ionos-sdr/ionos-maximus-rpi-sdr/docs/img/rev-a_on_rpi3b_iso.png

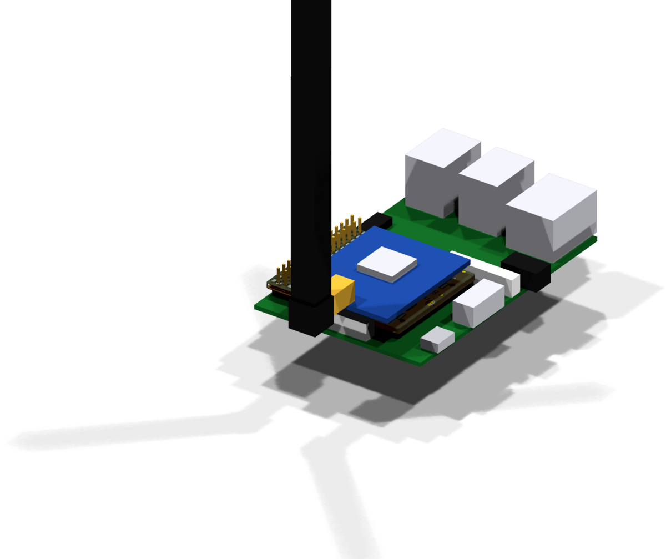
docs/img/rev-a_on_rpi3b_iso.png
