ionos-sdr/ionos-maximus-rpi-sdr/docs/img/rev-a_on_rpi3b_top.png

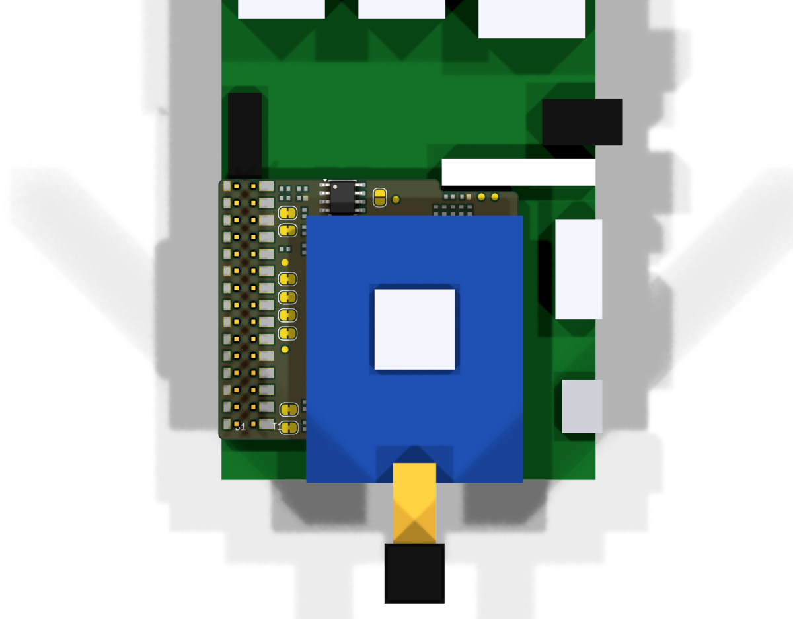
docs/img/rev-a_on_rpi3b_top.png
