ionos-sdr/ionos-maximus-rpi-sdr/docs/img/social_card.png

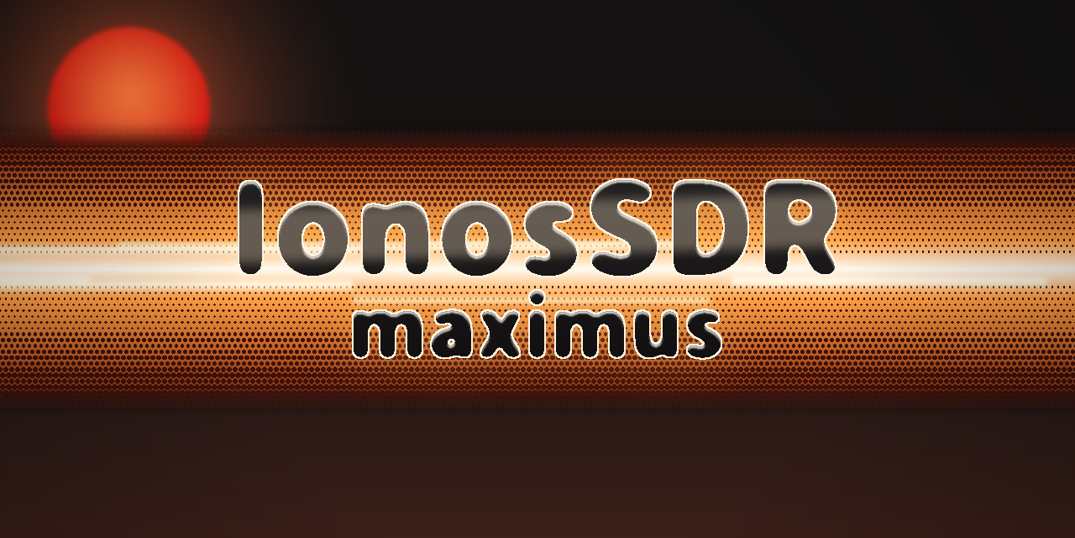
docs/img/social_card.png
