ionos-sdr/ionos-maximus-rpi-sdr/hardware/kicad/3dmodels/L5_0603.step

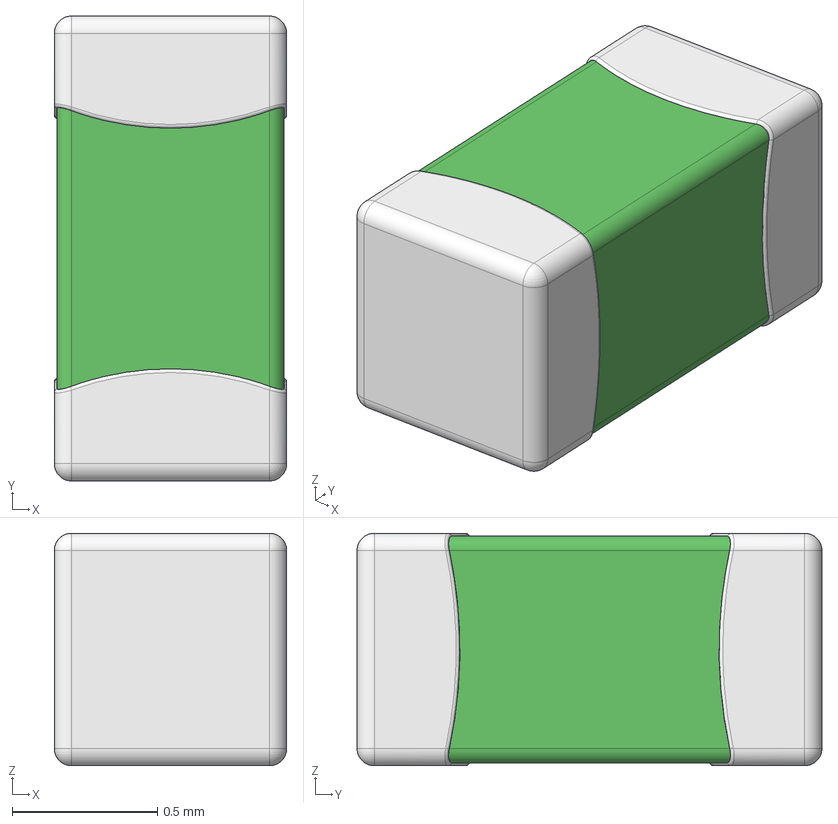
[picture p12: CAD file, 2026-10-26]
hardware/kicad/3dmodels/L5_0603.step
0.8 x 1.60 x 0.8 mm
Pin1 (1)
Pin2 (1)
CeramicBody (1)
