ionos-sdr/ionos-maximus-rpi-sdr/hardware/kicad/3dmodels/RESC1005X40_0402.step

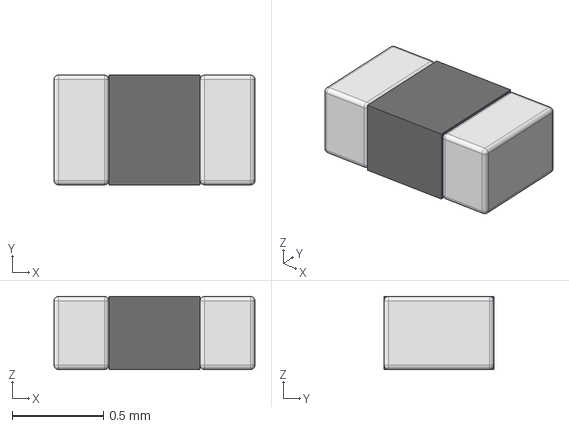
[picture p13: CAD file, 2026-10-26]
hardware/kicad/3dmodels/RESC1005X40_0402.step
1.10 x 0.6 x 0.4 mm
