ionos-sdr/ionos-maximus-rpi-sdr/hardware/kicad/3dmodels/SOT-23-5.step

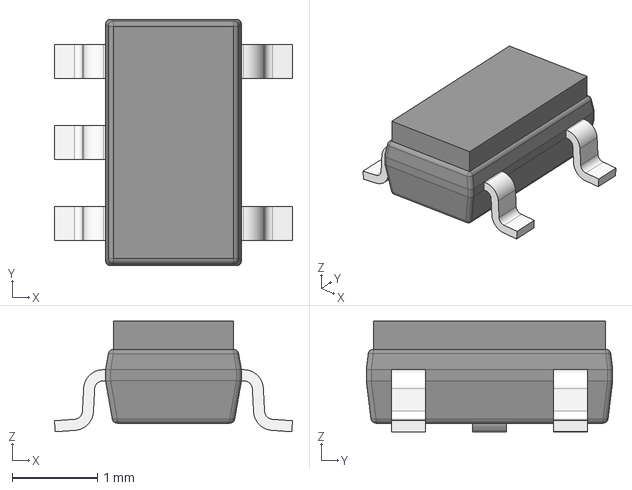
[picture p14: CAD file, 2026-10-26]
hardware/kicad/3dmodels/SOT-23-5.step
2.80 x 2.90 x 1.30 mm
BODY-SOT
LEAD-SOT x 5
