ionos-sdr/ionos-maximus-rpi-sdr/hardware/kicad/3dmodels/CAPC1005X60_0402.step

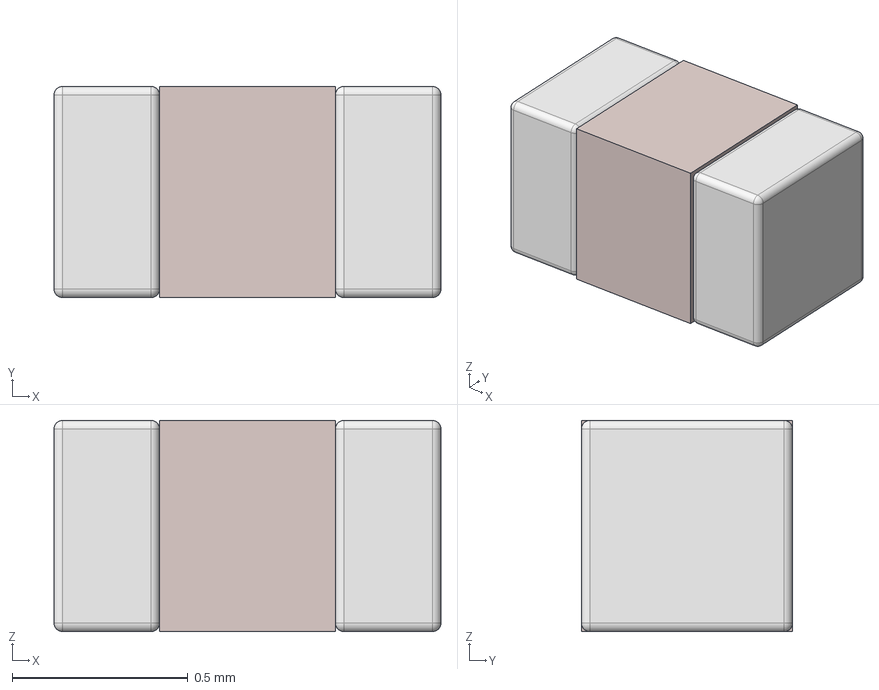
[picture p15: CAD file, 2026-10-26]
hardware/kicad/3dmodels/CAPC1005X60_0402.step
1.10 x 0.6 x 0.6 mm
