ionos-sdr/ionos-maximus-rpi-sdr/hardware/kicad/3dmodels/PinSocket_2x15_P2.54mm_Vertical_SMD.step

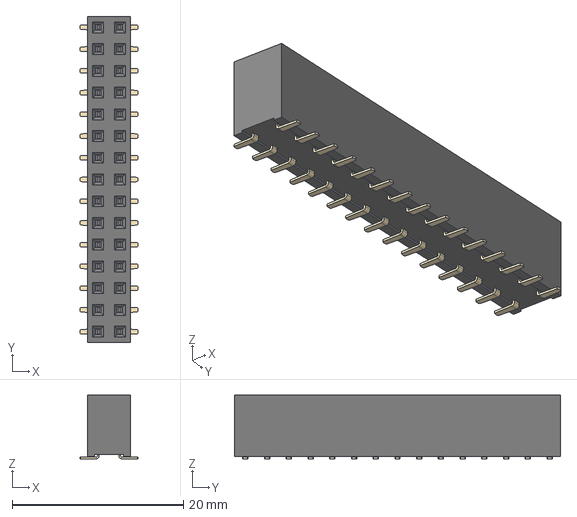
[picture p16: CAD file, 2026-10-26]
hardware/kicad/3dmodels/PinSocket_2x15_P2.54mm_Vertical_SMD.step
6.80 x 38.1 x 7.45 mm
