ionos-sdr/ionos-maximus-rpi-sdr/hardware/ionos_maximus_schematic.pdf

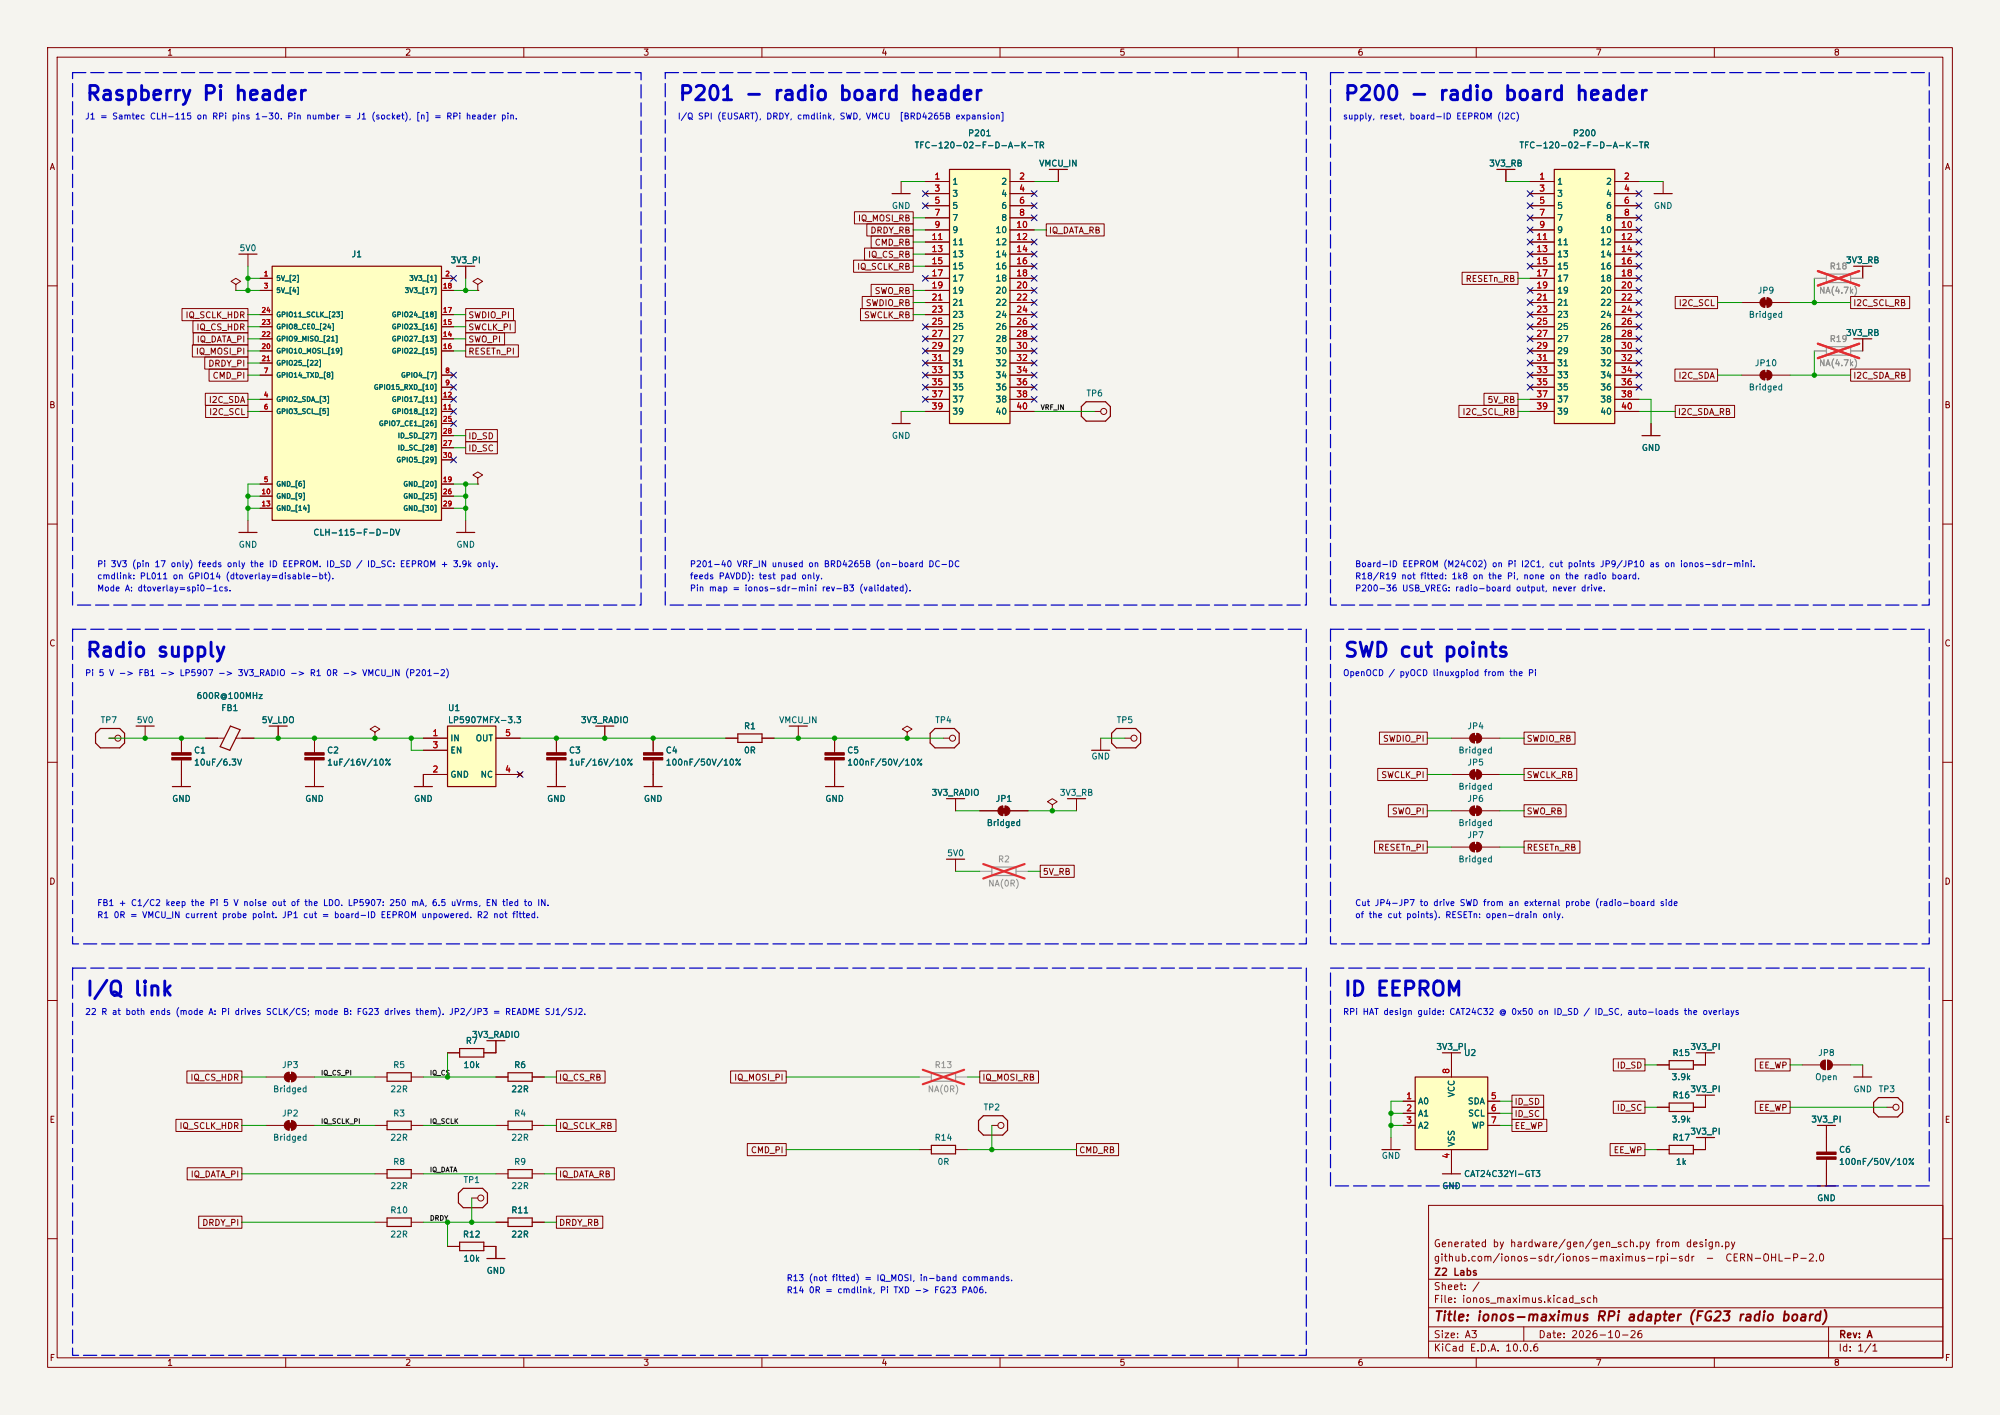
[picture p17: page 1]

J1 = Samtec CLH-115 on RPi pins 1-30. Pin number = J1 (socket), [n] = RPi header pin.

Cut JP4-JP7 to drive SWD from an external probe (radio-board side Pi 3V3 (pin 17 only) feeds only the ID EEPROM. ID_SD / ID_SC: EEPROM + 3.9k only. cmdlink: PL011 on GPIO14 (dtoverlay=disable-bt). Mode A: dtoverlay=spi0-1cs.
feeds PAVDD): test pad only. Pi 5 V -> FB1 -> LP5907 -> 3V3_RADIO -> R1 0R -> VMCU_IN (P201-2) 22 R at both ends (mode A: Pi drives SCLK/CS; mode B: FG23 drives them). JP2/JP3 = README SJ1/SJ2.

P201-40 VRF_IN unused on BRD4265B (on-board DC-DC

Board-ID EEPROM (M24C02) on Pi I2C1, cut points JP9/JP10 as on ionos-sdr-mini. SWD cut points

Pin map = ionos-sdr-mini rev-B3 (validated).

R18/R19 not fitted: 1k8 on the Pi, none on the radio board. of the cut points). RESETn: open-drain only. R13 (not fitted) = IQ_MOSI, in-band commands. R14 0R = cmdlink, Pi TXD -> FG23 PA06.

OpenOCD / pyOCD linuxgpiod from the Pi P200-36 USB_VREG: radio-board output, never drive. RPi HAT design guide: CAT24C32 @ 0x50 on ID_SD / ID_SC, auto-loads the overlays

Generated by hardware/gen/gen_sch.py from design.py
github.com/ionos-sdr/ionos-maximus-rpi-sdr - CERN-OHL-P-2.0
Z2 Labs
Sheet: /
File: ionos_maximus.kicad_sch
Title: ionos-maximus RPi adapter (FG23 radio board)

Size: A3 | Rev: A | F Date: 2026-10-26
KiCad E.D.A. 10.0.6 | Id: 1/1
