ionos-sdr/ionos-maximus-rpi-sdr/hardware/kicad/ionos_maximus.kicad_pcb

## KiCad design hardware/kicad/ionos_maximus.kicad_pcb (2026-10-27)

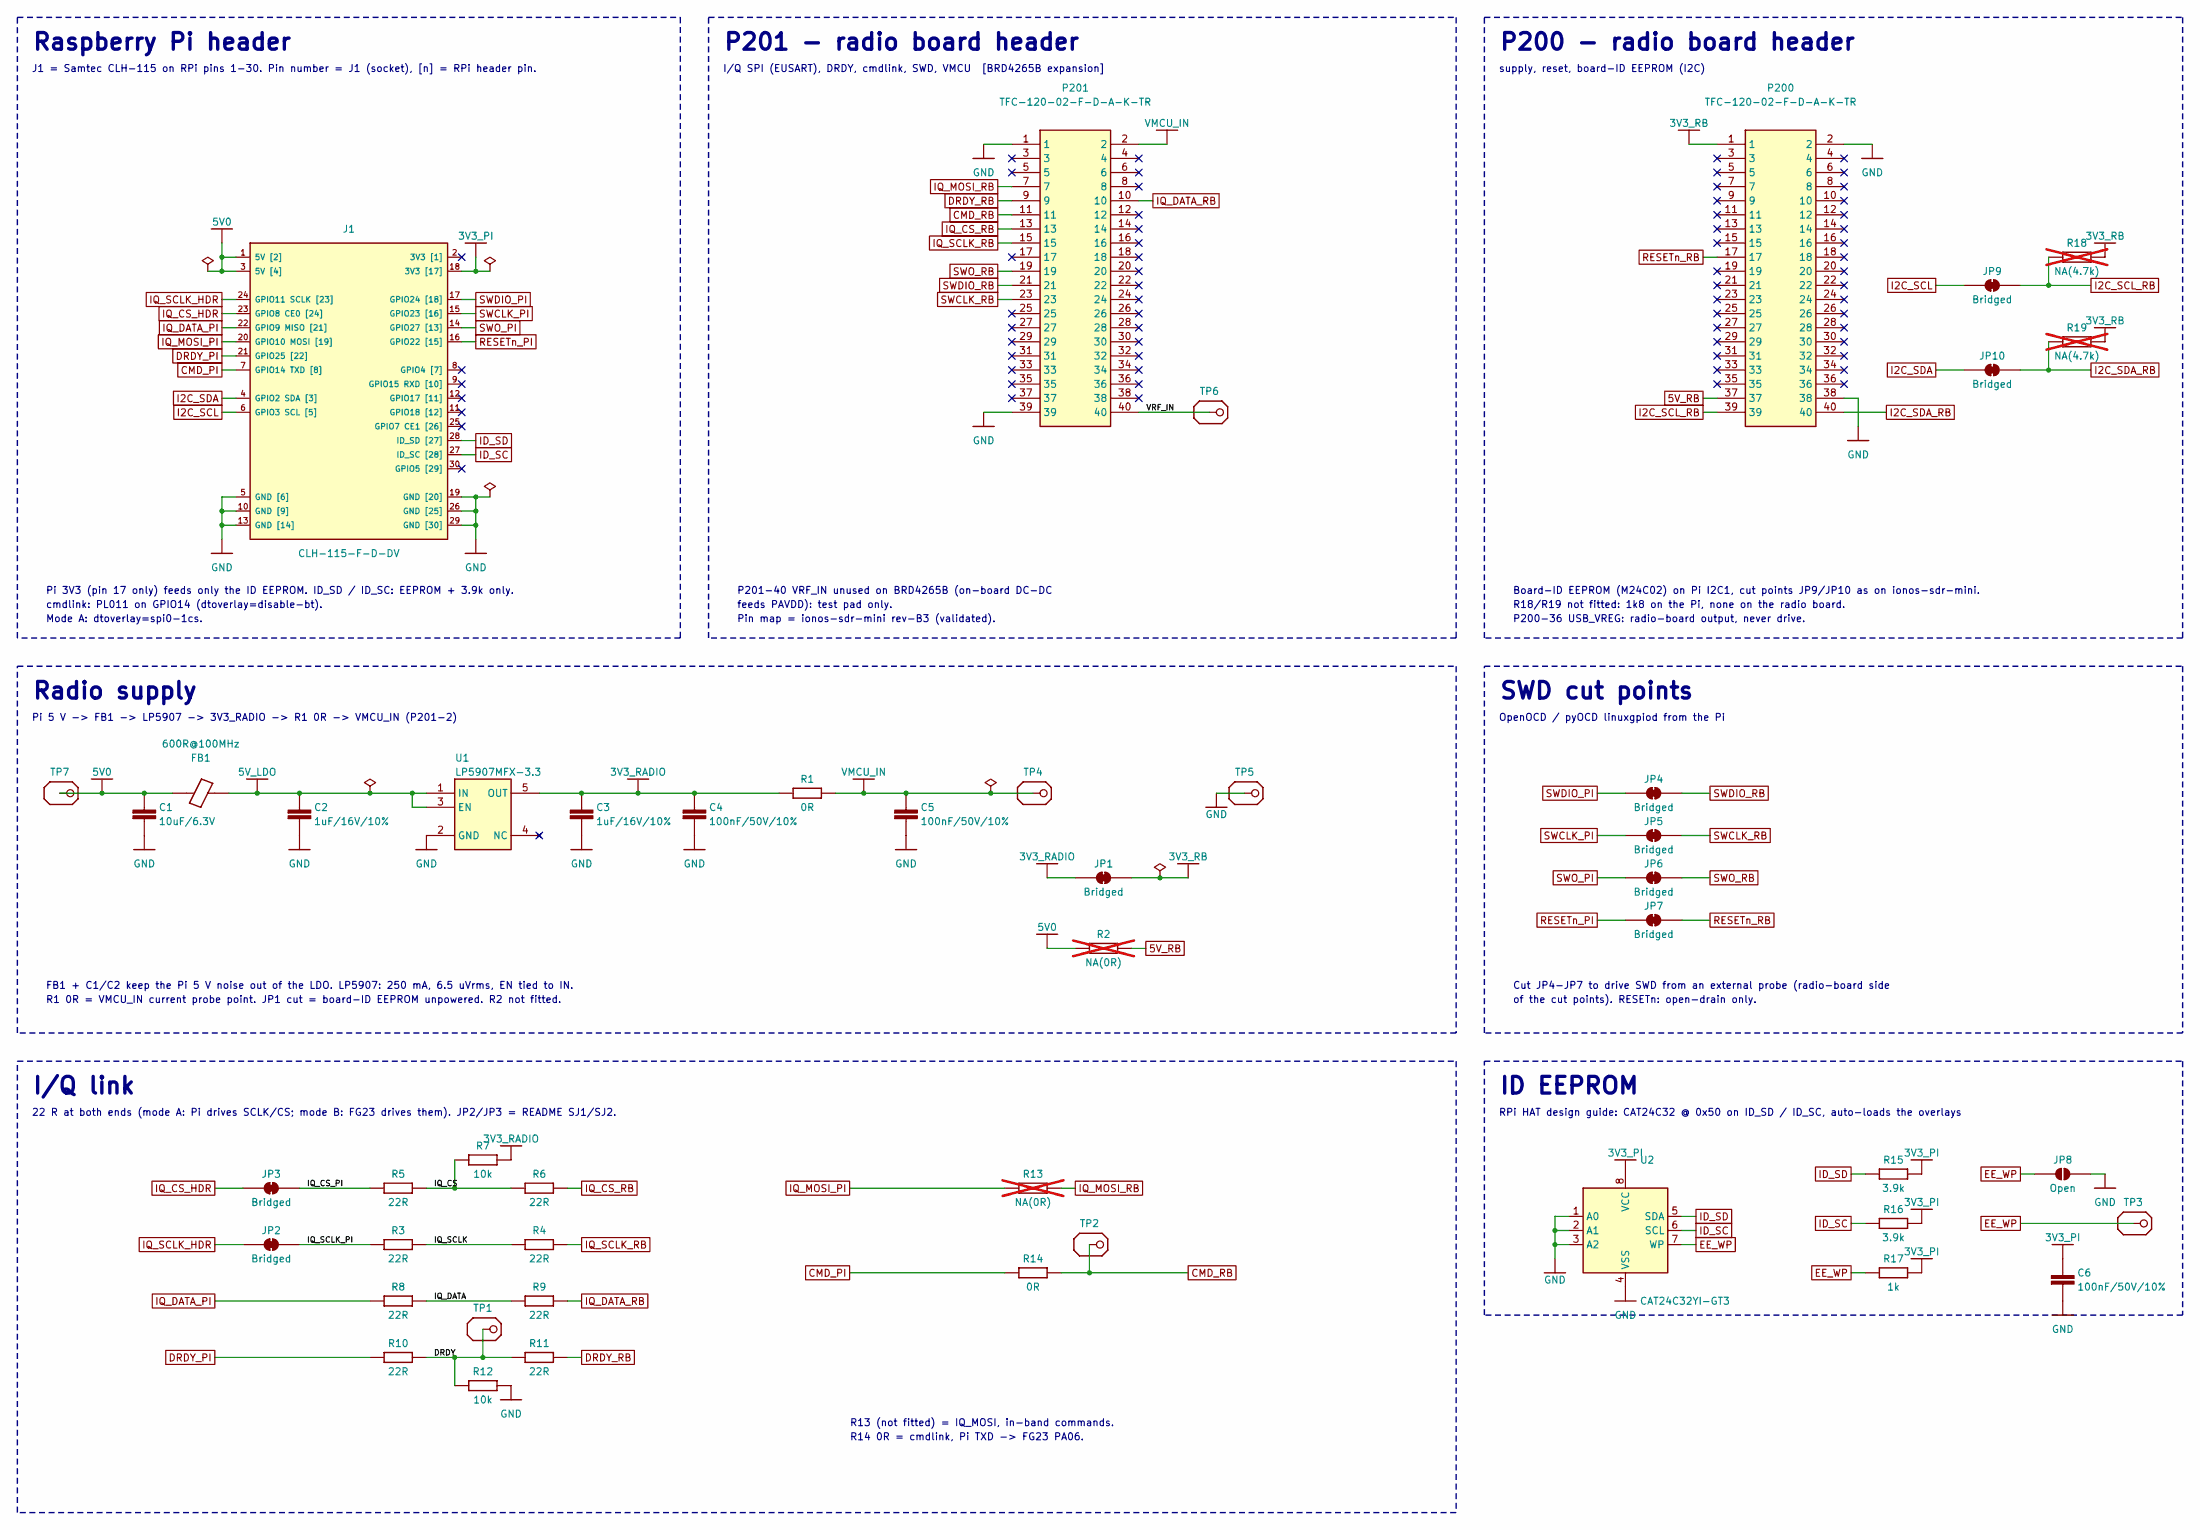
[picture p18: schematic ionos_maximus.kicad_sch, ionos-maximus RPi adapter (FG23 radio board)]

Parts:
C1: 10uF/6.3V; CAPC1005X60_0402
C2, C3: 1uF/16V/10%; CAPC1005X60_0402
C4, C5, C6: 100nF/50V/10%; CAPC1005X60_0402
FB1: 600R@100MHz; L5_0603
J1: CLH-115-F-D-DV; 2X15_SMT_CROSSPCB_ASSYM
JP1, JP2, JP3, JP4, JP5, JP6, JP7, JP9, JP10: Bridged; SolderJumper-2_P1.3mm_Bridged_RoundedPad1.0x1.5mm
JP8: Open; SolderJumper-2_P1.3mm_Open_RoundedPad1.0x1.5mm
P200, P201: TFC-120-02-F-D-A-K-TR; TFC-120-02-XX-D-A-K-TR
R1, R14: 0R; RESC1005X40_0402
R2, R13: NA(0R); RESC1005X40_0402; not fitted
R3, R4, R5, R6, R8, R9, R10, R11: 22R; RESC1005X40_0402
R7, R12: 10k; RESC1005X40_0402
R15, R16: 3.9k; RESC1005X40_0402
R17: 1k; RESC1005X40_0402
R18, R19: NA(4.7k); RESC1005X40_0402; not fitted
TP1: DRDY; TESTPOINT_40MIL_SMD
TP2: CMD; TESTPOINT_40MIL_SMD
TP3: EE_WP; TESTPOINT_40MIL_SMD
TP4: VMCU_IN; TESTPOINT_40MIL_SMD
TP5: GND; TESTPOINT_40MIL_SMD
TP6: VRF_IN; TESTPOINT_40MIL_SMD
TP7: 5V0; TESTPOINT_40MIL_SMD
U1: LP5907MFX-3.3; SOT-23-5
U2: CAT24C32YI-GT3; TSSOP-8_4.4x3mm_P0.65mm

Connections:
3V3_PI: C6.1, J1.18 (3V3 [17]), R15.2, R16.2, R17.2, U2.8 (VCC)
3V3_RADIO: C3.1, C4.1, JP1.1 (A), R1.1, R7.2, U1.5 (OUT)
3V3_RB: JP1.2 (B), P200.1, R18.2, R19.2
5V0: C1.1, FB1.1, J1.1 (5V [2]), J1.3 (5V [4]), R2.1, TP7.PP
5V_LDO: C2.1, FB1.2, U1.1 (IN), U1.3 (EN)
5V_RB: P200.37, R2.2
/DRDY: R10.2, R11.1, R12.1, TP1.PP
/IQ_CS: R5.2, R6.1, R7.1
/IQ_CS_PI: JP3.2 (B), R5.1
/IQ_DATA: R8.2, R9.1
/IQ_SCLK: R3.2, R4.1
/IQ_SCLK_PI: JP2.2 (B), R3.1
/VRF_IN: P201.40, TP6.PP
CMD_PI: J1.7 (GPIO14 TXD [8]), R14.1
CMD_RB: P201.11, R14.2, TP2.PP
DRDY_PI: J1.21 (GPIO25 [22]), R10.1
DRDY_RB: P201.9, R11.2
EE_WP: JP8.1 (A), R17.1, TP3.PP, U2.7 (WP)
GND: C1.2, C2.2, C3.2, C4.2, C5.2, C6.2, J1.5 (GND [6]), J1.10 (GND [9]), J1.13 (GND [14]), J1.19 (GND [20]), J1.26 (GND [25]), J1.29 (GND [30]), JP8.2 (B), P200.2, P200.38, P201.1, P201.39, R12.2, TP5.PP, U1.2 (GND), U2.1 (A0), U2.2 (A1), U2.3 (A2), U2.4 (VSS)
I2C_SCL: J1.6 (GPIO3 SCL [5]), JP9.1 (A)
I2C_SCL_RB: JP9.2 (B), P200.39, R18.1
I2C_SDA: J1.4 (GPIO2 SDA [3]), JP10.1 (A)
I2C_SDA_RB: JP10.2 (B), P200.40, R19.1
ID_SC: J1.27 (ID_SC [28]), R16.1, U2.6 (SCL)
ID_SD: J1.28 (ID_SD [27]), R15.1, U2.5 (SDA)
IQ_CS_HDR: J1.23 (GPIO8 CE0 [24]), JP3.1 (A)
IQ_CS_RB: P201.13, R6.2
IQ_DATA_PI: J1.22 (GPIO9 MISO [21]), R8.1
IQ_DATA_RB: P201.10, R9.2
IQ_MOSI_PI: J1.20 (GPIO10 MOSI [19]), R13.1
IQ_MOSI_RB: P201.7, R13.2
IQ_SCLK_HDR: J1.24 (GPIO11 SCLK [23]), JP2.1 (A)
IQ_SCLK_RB: P201.15, R4.2
RESETn_PI: J1.16 (GPIO22 [15]), JP7.1 (A)
RESETn_RB: JP7.2 (B), P200.17
SWCLK_PI: J1.15 (GPIO23 [16]), JP5.1 (A)
SWCLK_RB: JP5.2 (B), P201.23
SWDIO_PI: J1.17 (GPIO24 [18]), JP4.1 (A)
SWDIO_RB: JP4.2 (B), P201.21
SWO_PI: J1.14 (GPIO27 [13]), JP6.1 (A)
SWO_RB: JP6.2 (B), P201.19
VMCU_IN: C5.1, P201.2, R1.2, TP4.PP

Notes on the sheet:
Raspberry Pi header
J1 = Samtec CLH-115 on RPi pins 1-30. Pin number = J1 (socket), [n] = RPi header pin.
Pi 3V3 (pin 17 only) feeds only the ID EEPROM. ID_SD / ID_SC: EEPROM + 3.9k only.
cmdlink: PL011 on GPIO14 (dtoverlay=disable-bt).
Mode A: dtoverlay=spi0-1cs.
P201 - radio board header
I/Q SPI (EUSART), DRDY, cmdlink, SWD, VMCU [BRD4265B expansion]
P201-40 VRF_IN unused on BRD4265B (on-board DC-DC
feeds PAVDD): test pad only.
Pin map = ionos-sdr-mini rev-B3 (validated).
P200 - radio board header
supply, reset, board-ID EEPROM (I2C)
Board-ID EEPROM (M24C02) on Pi I2C1, cut points JP9/JP10 as on ionos-sdr-mini.
R18/R19 not fitted: 1k8 on the Pi, none on the radio board.
P200-36 USB_VREG: radio-board output, never drive.
Radio supply
Pi 5 V -> FB1 -> LP5907 -> 3V3_RADIO -> R1 0R -> VMCU_IN (P201-2)
FB1 + C1/C2 keep the Pi 5 V noise out of the LDO. LP5907: 250 mA, 6.5 uVrms, EN tied to IN.
R1 0R = VMCU_IN current probe point. JP1 cut = board-ID EEPROM unpowered. R2 not fitted.
I/Q link
22 R at both ends (mode A: Pi drives SCLK/CS; mode B: FG23 drives them). JP2/JP3 = README SJ1/SJ2.
R13 (not fitted) = IQ_MOSI, in-band commands.
R14 0R = cmdlink, Pi TXD -> FG23 PA06.
SWD cut points
OpenOCD / pyOCD linuxgpiod from the Pi
Cut JP4-JP7 to drive SWD from an external probe (radio-board side
of the cut points). RESETn: open-drain only.
ID EEPROM
RPi HAT design guide: CAT24C32 @ 0x50 on ID_SD / ID_SC, auto-loads the overlays

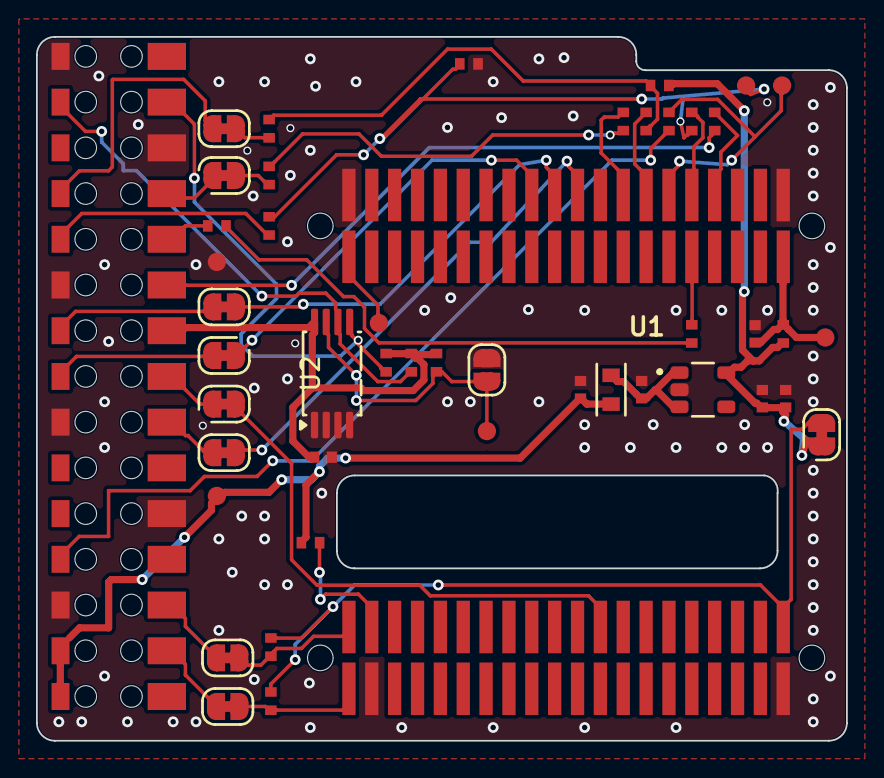
[picture p19: board ionos_maximus.kicad_pcb from above]

Board: 2 copper layers, 45.0 x 39.1 mm, 48 parts (0 on the bottom side), 42 nets.
