ionos-sdr/ionos-maximus-rpi-sdr/hardware/gen/render_context.py

"""Context renders: the adapter on a Raspberry Pi 4B, BRD4265B plugged in, SMA whip antenna.

Raspberry Pi 4B: STEP model from the FreeCAD parts library (github.com/FreeCAD/FreeCAD-library,
Computing/SingleBoardComputers/Raspberry/Raspberry Pi 4B), licensed CC-BY 3.0. It is downloaded into out/context
on first run and is not stored in this repository. Header, holes and outline match the Pi 3B / 5 as well.
Radio board: built here as a KiCad board from KiCad's library footprints and 3D models (CC-BY-SA) on the assumed
BRD4265B outline (no vendor CAD is available), exported to STEP and attached to a copy of the adapter.
Run with KiCad's Python:  python.exe render_context.py
"""
import os, math, subprocess, urllib.request
import pcbnew

PI_URL = ('https://raw.githubusercontent.com/FreeCAD/FreeCAD-library/master/Computing/SingleBoardComputers/'
          'Raspberry/Raspberry%20Pi%204B/Raspberry%20Pi%204B.step')

HERE = os.path.dirname(os.path.abspath(__file__))
KDIR = os.path.normpath(os.path.join(HERE, '..', 'kicad'))
OUT = os.path.normpath(os.path.join(HERE, '..', 'out', 'context'))
CLI = r'C:\Program Files\KiCad\10.0\bin\kicad-cli.exe'
FPL = r'C:\Program Files\KiCad\10.0\share\kicad\footprints'
IN = 25.4 / 10                       # VRML unit

# ---- Raspberry Pi, mechanical drawing frame: px along the header edge (0..85), py from the header edge (0..56).
# GPIO pin 1 at (8.37, 4.77); J1 hole of RPi pin 1 on the adapter is at (5.253, -2.457).
# The FreeCAD STEP is Y-up: x = px, z = py - 56, y = height above the Pi PCB top.
# Rotating it +90 deg about X gives board coords (px, py - 56); a footprint at orientation 90 maps that to
# (py - 56, -px), so the footprint sits at (P1X - 4.77 + 56, P1Y + 8.37).
P1X, P1Y = 5.253, -2.457
PI_POS = (P1X - 4.77 + 56.0, P1Y + 8.37)
PI_Z = -1.6 - 2.5                    # Pi PCB top: adapter bottom rests on the 2.5 mm header body

# ---- radio board stand-in (VERIFY on a real BRD4265B): 32.5 mm along the connectors, 11 mm beyond P200,
# 5 mm beyond P201; SMA on the P200 end; sockets on its bottom side.
XC, YP200, YP201 = 29.4, -4.6, -28.6
RB = (XC - 16.25, YP201 - 5.0, XC + 16.25, YP200 + 11.0)
RB_Z = 1.6 + 4.6                     # adapter top + mated TFM-120 / WCON stack (approx.)
RB_PARTS = [
    ('Connector_PinSocket_1.27mm:PinSocket_2x20_P1.27mm_Vertical_SMD', XC, YP200, 90, 'B'),
    ('Connector_PinSocket_1.27mm:PinSocket_2x20_P1.27mm_Vertical_SMD', XC, YP201, 90, 'B'),
    ('Package_DFN_QFN:QFN-48-1EP_7x7mm_P0.5mm_EP5.15x5.15mm', XC, -15.5, 45, 'F'),
    ('Crystal:Crystal_SMD_3225-4Pin_3.2x2.5mm', XC - 7.0, -19.0, 0, 'F'),
    ('Connector_Coaxial:SMA_Samtec_SMA-J-P-H-ST-EM1_EdgeMount', XC, RB[3], 270, 'F'),
    ('Package_TO_SOT_SMD:SOT-23-5', XC + 9.0, -27.0, 0, 'F'),
    ('Inductor_SMD:L_0603_1608Metric', XC + 6.0, -9.0, 0, 'F'),
] + [('Capacitor_SMD:C_0402_1005Metric', XC + dx, y, 90, 'F')
     for dx, y in ((-3.0, -9.0), (-1.5, -9.0), (0.0, -9.0), (1.5, -9.0), (3.0, -9.0), (5.0, -20.0),
                   (6.5, -20.0), (-5.0, -12.0), (-5.0, -10.5), (2.0, -3.0), (-2.0, -3.0))] + \
    [('Resistor_SMD:R_0402_1005Metric', XC + dx, -24.0, 0, 'F') for dx in (-8.0, -6.0, 6.0, 8.0)]


def load(fpid):
    lib, name = fpid.split(':')
    fp = pcbnew.FootprintLoad(os.path.join(FPL, lib + '.pretty'), name)
    fp.SetFPID(pcbnew.LIB_ID(lib, name))
    return fp


def v(x, y):
    return pcbnew.VECTOR2I(pcbnew.FromMM(x), pcbnew.FromMM(y))


def outline(b, pts, r):
    """Closed outline with rounded corners (pts in order, convex)."""
    n = len(pts)
    for i in range(n):
        a, c, d = pts[i - 1], pts[i], pts[(i + 1) % n]
        u = ((a[0] - c[0]), (a[1] - c[1])); w = ((d[0] - c[0]), (d[1] - c[1]))
        lu, lw = math.hypot(*u), math.hypot(*w)
        p1 = (c[0] + u[0] / lu * r, c[1] + u[1] / lu * r)
        p2 = (c[0] + w[0] / lw * r, c[1] + w[1] / lw * r)
        mid = (c[0] + (u[0] / lu + w[0] / lw) * r * (1 - math.sqrt(0.5)), c[1] + (u[1] / lu + w[1] / lw) * r * (1 - math.sqrt(0.5)))
        arc = pcbnew.PCB_SHAPE(b, pcbnew.SHAPE_T_ARC)
        arc.SetArcGeometry(v(*p1), v(*mid), v(*p2))
        arc.SetLayer(pcbnew.Edge_Cuts); arc.SetWidth(pcbnew.FromMM(0.1)); b.Add(arc)
        ln = pcbnew.PCB_SHAPE(b, pcbnew.SHAPE_T_SEGMENT)
        q1 = p2
        q2 = (d[0] - w[0] / lw * r, d[1] - w[1] / lw * r)
        ln.SetStart(v(*q1)); ln.SetEnd(v(*q2)); ln.SetLayer(pcbnew.Edge_Cuts); ln.SetWidth(pcbnew.FromMM(0.1)); b.Add(ln)


def hole(b, x, y, d):
    fp = pcbnew.FOOTPRINT(b)
    pad = pcbnew.PAD(fp)
    pad.SetAttribute(pcbnew.PAD_ATTRIB_NPTH); pad.SetShape(pcbnew.PAD_SHAPE_CIRCLE)
    pad.SetSize(v(d, d)); pad.SetDrillSize(v(d, d)); pad.SetLayerSet(pad.UnplatedHoleMask())
    fp.Add(pad); fp.SetPosition(v(x, y)); b.Add(fp)


def place(b, fpid, x, y, rot, side):
    fp = load(fpid)
    fp.Reference().SetVisible(False); fp.Value().SetVisible(False)
    b.Add(fp)
    fp.SetPosition(v(x, y)); fp.SetOrientationDegrees(rot)
    if side == 'B':
        fp.Flip(fp.GetPosition(), pcbnew.FLIP_DIRECTION_TOP_BOTTOM)
    return fp


def build(path, corners, r, parts, holes, color):
    b = pcbnew.NewBoard(path)
    outline(b, corners, r)
    for x, y, d in holes:
        hole(b, x, y, d)
    for p in parts:
        place(b, *p)
    b.Save(path)


def step(pcb, out):
    subprocess.run([CLI, 'pcb', 'export', 'step', '--force', '--user-origin', '0x0mm', '--subst-models',
                    '-o', out, pcb], check=True, capture_output=True)


def vcyl(x, y, z, r, h, axis, rgb, n=40):
    """Cylinder as an IndexedFaceSet (board coords: y down; axis 'z' vertical or 'y' along the board)."""
    pts, faces = [], []
    for k in range(n):
        a = 2 * math.pi * k / n
        c, s_ = r * math.cos(a), r * math.sin(a)
        for t in (-h / 2, h / 2):
            if axis == 'z':
                px, py, pz = x + c, y + s_, z + t
            else:
                px, py, pz = x + c, y + t, z + s_
            pts.append((px / IN, -py / IN, pz / IN))
    for k in range(n):
        a0, a1, b0, b1 = 2 * k, 2 * k + 1, 2 * ((k + 1) % n), 2 * ((k + 1) % n) + 1
        faces.append((a0, b0, b1, a1))
    faces.append(tuple(2 * k for k in range(n))[::-1])
    faces.append(tuple(2 * k + 1 for k in range(n)))
    return ('Shape { appearance Appearance { material Material { diffuseColor %.3f %.3f %.3f specularColor 0.3 0.3 0.3 '
            'shininess 0.4 } } geometry IndexedFaceSet { solid FALSE coord Coordinate { point [ %s ] } coordIndex [ %s ] } }\n'
            % (rgb[0], rgb[1], rgb[2], ', '.join('%.4f %.4f %.4f' % p for p in pts),
               ', '.join(' '.join(map(str, f)) + ' -1' for f in faces)))


def antenna(path):
    """Hinged 868 MHz whip on the SMA: gold coupling nut, black hinge, black radome, bent upright."""
    x, y0, z = XC, RB[3] + 7.0, RB_Z + 0.8
    gold, black = (0.85, 0.68, 0.25), (0.05, 0.05, 0.05)
    s = [vcyl(x, y0 + 3.0, z, 4.0, 6.0, 'y', gold),           # coupling nut
         vcyl(x, y0 + 7.5, z, 4.6, 3.0, 'y', black),          # hinge
         vcyl(x, y0 + 9.0, z + 37.0, 4.4, 70.0, 'z', black),   # radome, lower part
         vcyl(x, y0 + 9.0, z + 87.0, 3.7, 30.0, 'z', black),   # radome, upper part
         vcyl(x, y0 + 9.0, z + 103.0, 2.6, 2.0, 'z', black)]   # tip
    open(path, 'w').write('#VRML V2.0 utf8\n' + ''.join(s))


def main():
    os.makedirs(OUT, exist_ok=True)
    pi_step = os.path.join(OUT, 'pi4b.step')
    if not os.path.exists(pi_step) or os.path.getsize(pi_step) < 1e6:
        print('downloading', PI_URL)
        urllib.request.urlretrieve(PI_URL, pi_step)
    rb = os.path.join(OUT, 'brd4265b.kicad_pcb')
    build(rb, [(RB[0], RB[1]), (RB[2], RB[1]), (RB[2], RB[3]), (RB[0], RB[3])], 1.0, RB_PARTS, [], '#14191F')
    step(rb, os.path.join(OUT, 'brd4265b.step'))
    antenna(os.path.join(OUT, 'antenna.wrl'))
    # adapter copy with the context models
    b = pcbnew.LoadBoard(os.path.join(KDIR, 'ionos_maximus.kicad_pcb'))

    def ctx_fp(ref, pos, rot, models):
        fp = pcbnew.FOOTPRINT(b)
        fp.SetReference(ref); fp.Reference().SetVisible(False); fp.Value().SetVisible(False)
        fp.SetBoardOnly(True); fp.SetExcludedFromBOM(True); fp.SetExcludedFromPosFiles(True)
        for name, z, mrot in models:
            m = pcbnew.FP_3DMODEL()
            m.m_Filename = os.path.join(OUT, name).replace('\\', '/')
            m.m_Offset = pcbnew.VECTOR3D(0, 0, z)
            m.m_Rotation = pcbnew.VECTOR3D(*mrot)
            fp.Models().append(m)
        b.Add(fp)
        fp.SetPosition(v(*pos)); fp.SetOrientationDegrees(rot)

    ctx_fp('CTX1', (0, 0), 0, [('brd4265b.step', RB_Z, (0, 0, 0)), ('antenna.wrl', 0.0, (0, 0, 0))])
    ctx_fp('CTX2', PI_POS, 90, [('pi4b.step', PI_Z, (-90, 0, 0))])   # KiCad applies the negated angle
    ctx = os.path.join(KDIR, '_context.kicad_pcb')       # next to the project, so ${KIPRJMOD} models resolve
    b.Save(ctx)
    print('built', ctx)
    views = [('iso', '-62,0,150', '0.27'), ('iso_back', '-62,0,35', '0.28'), ('side', '-88,0,-90', '0.30'),
             ('top', '0,0,0', '0.55')]
    only = os.environ.get('VIEWS')
    if only:
        views = [x for x in views if x[0] in only.split(',')]
    for tag, rot, zoom in views:
        subprocess.run([CLI, 'pcb', 'render', '--side', 'top', '--rotate', rot, '--zoom', zoom, '--perspective',
                        '--floor', '--width', '1800', '--height', '1350', '--quality', os.environ.get('Q', 'high'),
                        '-o', os.path.join(OUT, 'stack_%s.png' % tag), ctx], check=True, capture_output=True)
        print('rendered', tag)


if __name__ == '__main__':
    main()
