ionos-sdr/ionos-maximus-rpi-sdr/(commit log)

2026-10-25 Initial concept: RPi host for Ionos SDR, pin map, rate budget, measurement plan
2026-10-25 Add link modes A/B (Pi main vs FG23 main via RP1 PIO), 22 ohm both ends, debug solder jumpers
    Claude-Session: https://claude.ai/code/session_01VmhnCpuZREn4Ep3WvbVNhp
2026-10-26 Hardware rev A: RPi adapter for the FG23 radio board - house-style schematic (ERC 0), HAT ID EEPROM, footprints and 3D models, placement on the RPi_ISM frame (DRC 0 errors, parity 0), not routed
2026-10-26 Docs from the twin: BRD4265B has no BOARD_ID SDA/SCL pull-ups (Pi 1k8 serve I2C1); P200-37 is USB_VBUS, not 5V
2026-10-26 P200 board-ID I2C as on ionos-sdr-mini: JP9/JP10 cut points, R18/R19 4.7k pull-ups (DNP, the Pi has 1k8)
2026-10-26 Context renders: rev A on a Raspberry Pi 3B with the radio board and an SMA whip (box stand-ins, render_stack.py)
2026-10-26 hardware: rev A routed, realistic 3D renders
    - Board routed on 2 layers with GND pour on both sides.
    DRC: 0 errors, 0 unconnected, schematic parity 0.
    - J2 (TC2030, DNP) removed. U2 changed to TSSOP-8 and moved to
    the P200/P201 band.
    - 3V3_PI taken from RPi pin 17 only. Rule-area keepout over the slot.
    - gen/render_context.py: Pi 3 + radio board + SMA antenna context
    renders, built from KiCad library stand-ins.
    - README images updated.
    Claude-Session: https://claude.ai/code/session_01NdGLVAcWNnBXKQpCaswFNe
2026-10-26 renders: real Raspberry Pi 4B model instead of library stand-ins
    The Pi stand-in had broken stacked USB ports and a misoriented HDMI connector.
    It is replaced by the Pi 4B STEP model from the FreeCAD parts library (CC-BY 3.0).
    The model is downloaded at render time and is not committed. Its header,
    holes and outline match the Pi 3B and Pi 5.
    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
2026-10-27 hardware: JLCPCB fabrication + assembly files, DFM clean-up, final renders
    - kicad/jlc/: Gerber zip, BOM (one line per LCSC code), CPL, full BOM,
    not-assembled list, part table. 26 top-side parts, 12 BOM lines.
    Every LCSC code was checked on jlcpcb.com / lcsc.com.
    - CPL rotation and centre come from fitting JLC's footprint of each part
    onto the pads. P200/P201 (TFM-120, no EasyEDA model) keep KiCad's origin.
    - J1 CLH-115 is not stocked at LCSC: use JLC Global Sourcing or hand-solder.
    - Board DFM changes for JLC rules:
    - 9 vias moved off SMD pads (ring to pad >= 0.15 mm);
    - silkscreen cleared from via holes;
    - off-board J1 pin labels moved to Fab.
    - Result: DRC 0 errors, 0 uncon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
