ionos-sdr/ionos-maximus-rpi-sdr/(notices)

Notices in the files:
hardware/kicad/3dmodels/PinSocket_2x15_P2.54mm_Vertical_SMD.step:
Copyright (C) 2024, KiCAD
This work is licensed under the
[Creative Commons CC-BY-SA 4.0 License](https://creativecommons.org/licenses/by-sa/4.0/legalcode),
with the following exception:
project files under this or any other license agreement. However, if you wish to distribute
